ExpressCook/PowerDistributionPCB/Connection and Mounting Description.pdf

Mounting and Connection of Power Distribution Board:

The board is mounted using the 4 hole on each corner.
The top side is the input, thee left side is the 5v output which connect to the beagle bone and its peripherals, the right side is the 12v output which powers the motor system.
