ExpressCook/PowerDistributionPCB/BOM.xlsx

Table 1
What | Number | Adress
TVS DIO 5v | 1+4 | http://www.digikey.com/product-detail/en/SMAJ5.0A/SMAJ5.0ABCT-ND/2254241
TVS DIO 12v | 7+3 | http://www.digikey.com/product-detail/en/SMAJ12CA/SMAJ12CABCT-ND/2254233
Cap 220uF | 5+5 | http://www.digikey.com/product-detail/en/EEE-1CA221XP/PCE3885CT-ND/766261
Cap 10uF | 3+7 | http://www.digikey.com/product-detail/en/TMK316F106ZL-T/587-1353-1-ND/931130
Cap 0.2uF | 1+4 | http://www.digikey.com/product-detail/en/C1206C224K5RACTU/399-1251-1-ND/411526
Regulator 5V | 1+1 | http://www.digikey.com/product-detail/en/MIC29500-5.0WT/576-1143-ND/771612
Sabre 43160 | 1+1 | http://www.molex.com/molex/products/datasheet.jsp?part=active/0431601102_PCB_HEADERS.xml
Cgrid 0553 | 5+5 | http://www.digikey.com/product-search/en?mpart=0705530001&vendor=900
Mini FIt jr 5566 | 6+4 | http://www.digikey.com/product-detail/en/39-29-9026/WM3864-ND/2002670
Fuse 2A | 8 | http://www.digikey.com/product-detail/en/39612000440/WK4457BK-ND/245408
Fuse 4A | 4 | http://www.digikey.com/product-detail/en/39214000000/F5505CT-ND/3306895
Fuse 5A | 2 | http://www.digikey.com/product-detail/en/39615000000/WK6280CT-ND/3307368
Fuse 15a | 2 | http://www.littelfuse.com/products/fuses/cartridge-fuses/5x20mm-fuses/215/215015.aspx
Fuse 15a holder | 2 | http://www.digikey.com/product-detail/en/65600001009/WK6245-ND/653441
LED | 2 | http://www.digikey.com/product-detail/en/LTW-2S3D8/160-1850-ND/2666499
r1206 250 | 1 | http://www.digikey.com/product-detail/en/Y1630250R000T9R/Y1630-250BCT-ND/4340638
r1206 1200 | 1 | http://www.digikey.com/product-detail/en/ERJ-8GEYJ122V/P1.2KECT-ND/203260
heat sink | 1+1 | http://www.digikey.com/product-detail/en/7-340-2PP-BA/294-1080-ND/272718
Following is Not on board
Cgrid - plug | 5+5 | http://www.digikey.com/product-detail/en/15-38-8020/WM4585-ND/505815
Fit jr - plug | 6+4 | http://www.molex.com/molex/products/datasheet.jsp?part=active/0039012020_CRIMP_HOUSINGS.xml
Sabre - plug | 1+1 | http://www.molex.com/molex/products/datasheet.jsp?part=active/0444411002_CRIMP_HOUSINGS.xml
