ExpressCook/PowerDistributionPCB/power system.brd

## EAGLE design power system.brd (2014-11-01)

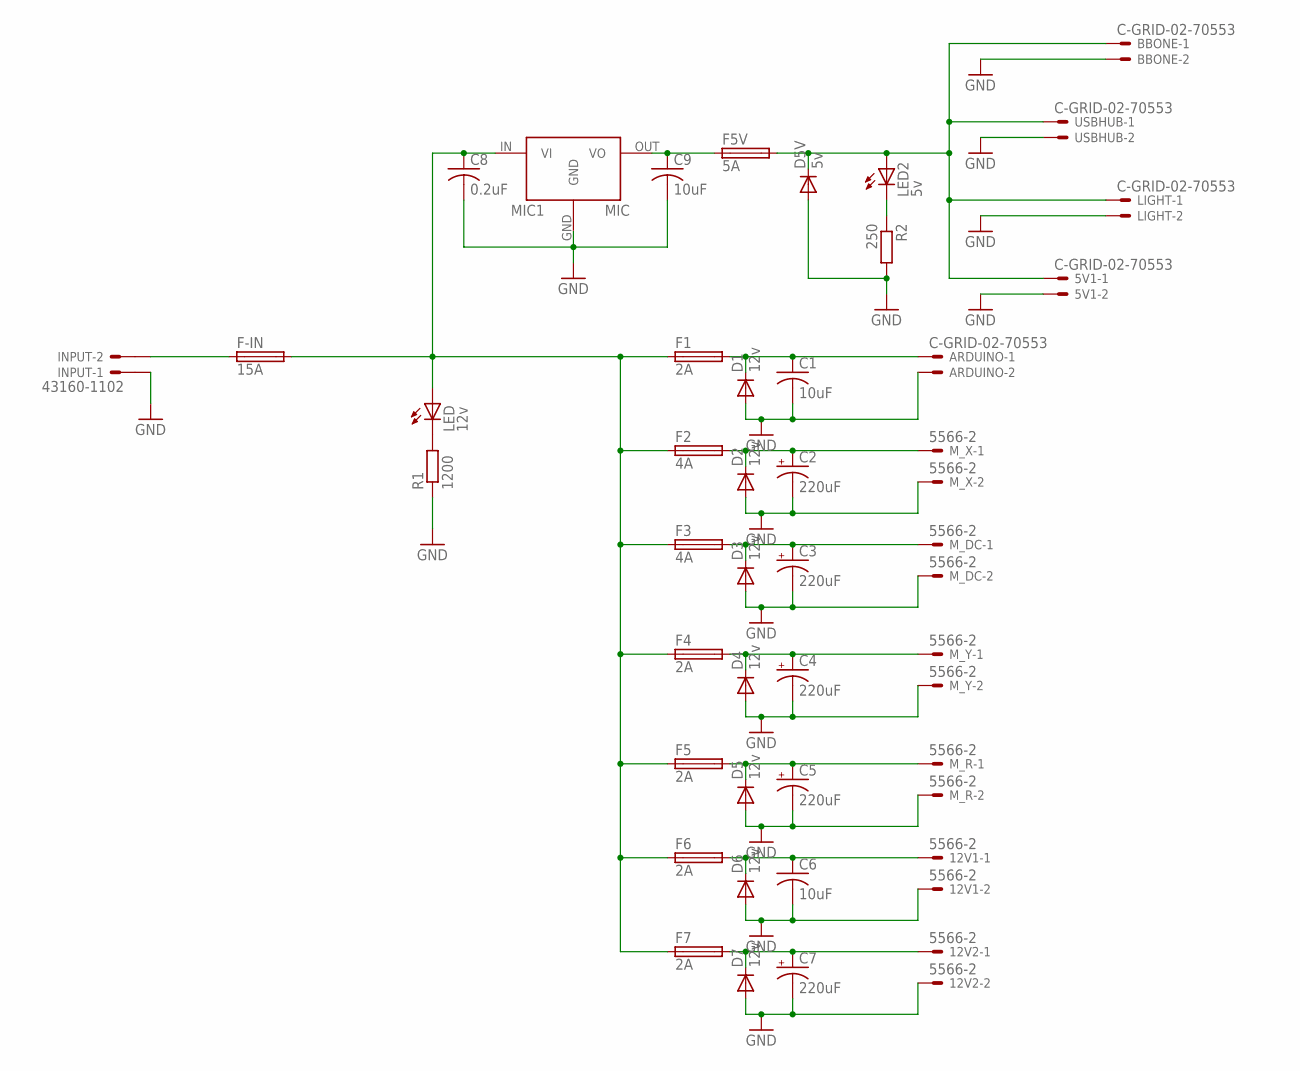
[picture p1: schematic power system.sch]

Parts:
5V1: C-GRID-02-70553; 70553-02
12V1, 12V2: 5566-2
ARDUINO: C-GRID-02-70553; 70553-02
BBONE: C-GRID-02-70553; 70553-02
C1, C6, C9: 10uF; C1206
C2, C3, C4, C5, C7: 220uF; NIPPON_F80
C8: 0.2uF; C1206
D1, D2, D3, D4, D5, D6, D7: 12v; DO214AC
D5V: 5v; DO214AC
F1, F4, F5, F6, F7: 2A; TE5
F2, F3: 4A; TE5
F5V: 5A; TE5
F-IN: 15A; FUSE_HOLDER_5X20MM
INPUT: 43160-1102; 43160-XX02
LED: 12v; LED5MM
LED2: 5v; LED5MM
LIGHT: C-GRID-02-70553; 70553-02
MIC1: MIC29300; TO220CS
M_DC: 5566-2
M_R: 5566-2
M_X: 5566-2
M_Y: 5566-2
R1: 1200; R1206
R2: 250; R1206
USBHUB: C-GRID-02-70553; 70553-02

Connections:
GND: 5V1.2, 12V1.2, 12V2.2, ARDUINO.2, BBONE.2, C1.2, C2.-, C3.-, C4.-, C5.-, C6.2, C7.-, C8.2, C9.2, D1.A, D2.A, D3.A, D4.A, D5.A, D5V.A, D6.A, D7.A, INPUT.1@1, LIGHT.2, MIC1.GND, M_DC.2, M_R.2, M_X.2, M_Y.2, R1.1, R2.2, USBHUB.2
unnamed: ARDUINO.1, C1.1, D1.C, F1.2
unnamed: F-IN.1, INPUT.2@1
unnamed: C2.+, D2.C, F2.2, M_X.1
unnamed: 5V1.1, BBONE.1, D5V.C, F5V.2, LED2.A, LIGHT.1, USBHUB.1
unnamed: C3.+, D3.C, F3.2, M_DC.1
unnamed: C9.1, F5V.1, MIC1.OUT (VO)
unnamed: C8.1, F1.1, F2.1, F3.1, F4.1, F5.1, F6.1, F7.1, F-IN.2, LED.A, MIC1.IN (VI)
unnamed: LED2.K (C), R2.1
unnamed: C4.+, D4.C, F4.2, M_Y.1
unnamed: LED.K (C), R1.2
unnamed: C5.+, D5.C, F5.2, M_R.1
unnamed: 12V1.1, C6.1, D6.C, F6.2
unnamed: 12V2.1, C7.+, D7.C, F7.2

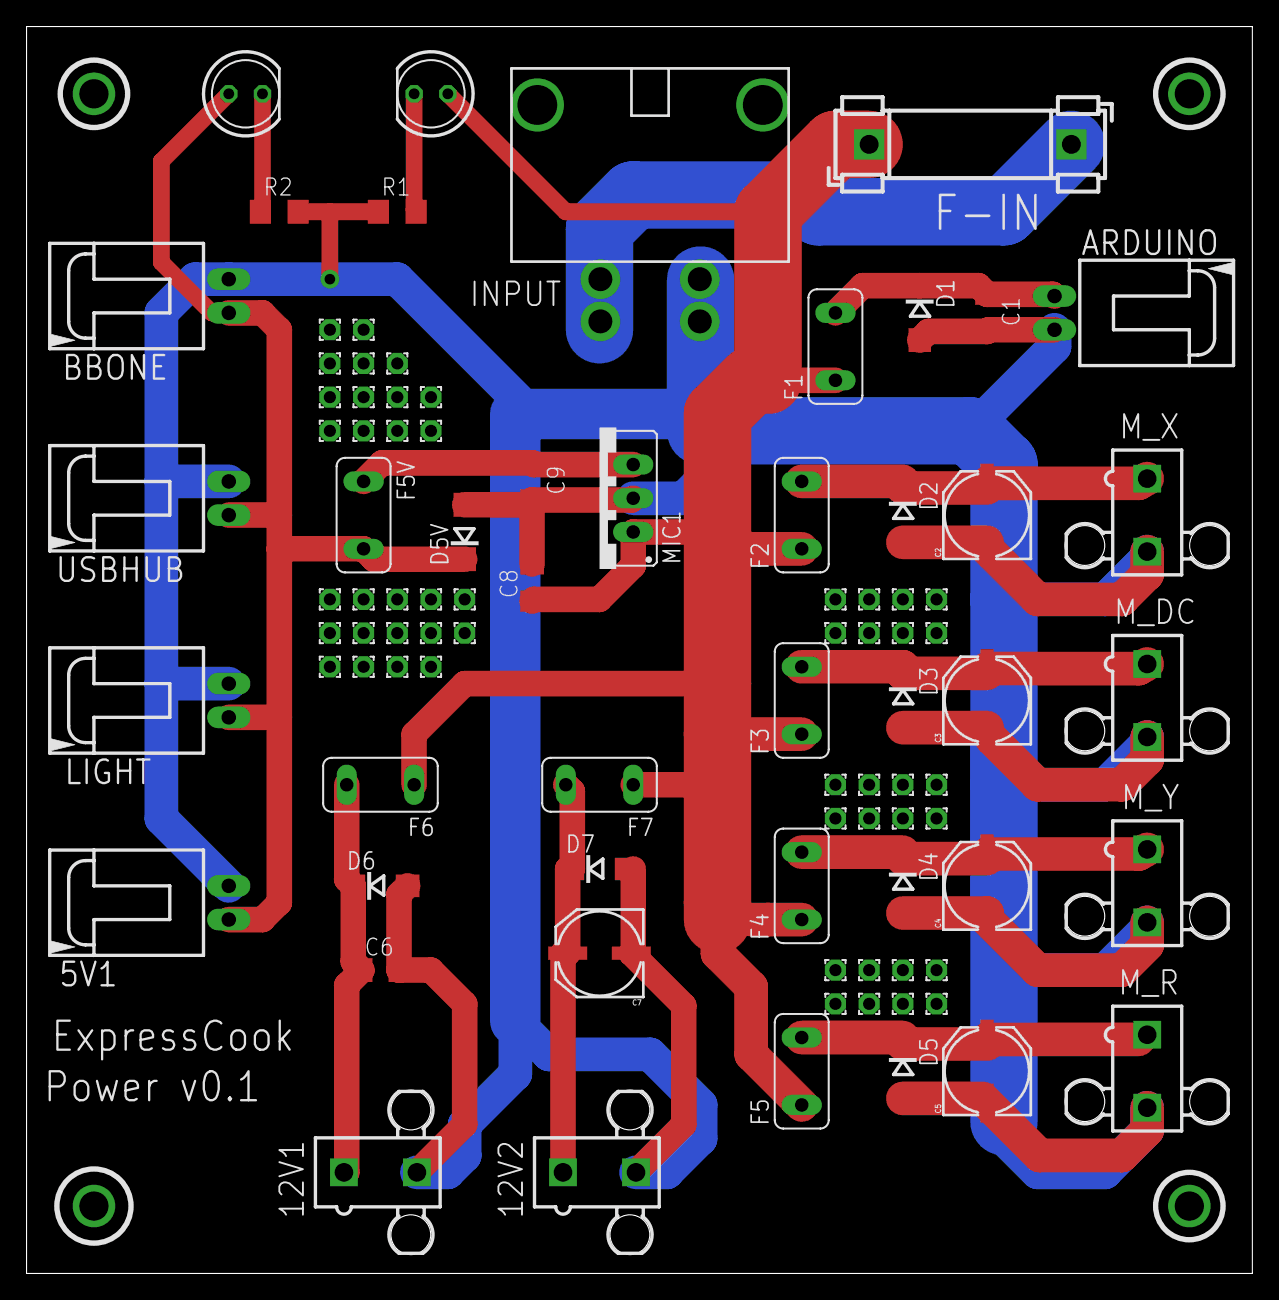
[picture p2: board power system.brd from above]

Board: 2 copper layers, 92.4 x 94.0 mm, 94 parts (0 on the bottom side), 14 nets.

Other parts of the board:
E$1, E$2, E$3, E$4, E$5, E$6, E$7, E$8, E$9, E$10, E$11, E$12, E$13, E$14, E$15, E$16, E$17, E$18, E$19, E$20, E$21, E$22, E$24, E$25, E$26, E$27, E$30, E$31, E$32, E$33, E$34, E$35, E$36, E$37, E$38, E$39, E$40, E$41, E$42, E$43, E$44, E$45, E$46, E$48, E$49, E$50, E$51, E$52, E$53, E$54, E$55: 1,6/0,9
