ExpressCook/PowerDistributionPCB/(commit log)

2014-10-31 init pcb
    [BOM.xlsx, power system with extra pads.brd, power system.brd, power system.sch]
2014-10-31 add heat sink
2014-11-01 1. increase the wire width 2. merge the two brd file 3. change the fuse value and connector order 4. approve the DRC error
    [BOM.xlsx, power system.brd, power system.sch]
2014-11-01 clear the file
    [power system with extra pads.brd]
2014-11-01 increas track to 20
    [power system.brd]
2014-11-03 1. add the Gerber files1. add the Gerber files1. add the Gerber files1. add the Gerber files1. add the Gerber files1. add the Gerber files1. add the Gerber files1. add the Gerber files1. add the Gerb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
2014-11-06 BOM change
    [BOM.xlsx]
